oscargao98/4180_Final_Project/1_garden/Speaker.h

#include "mbed.h"
// a new class to play a note on Speaker based on PwmOut class
class Speaker
{
public:
    Speaker(PinName pin) : _pin(pin) {
// _pin(pin) means pass pin to the Speaker Constructor
    }
// class method to play a note based on PwmOut class
    void PlayNote(float frequency, float duration, float volume) {
        _pin.period(1.0/frequency);
        _pin = volume/2.0;
        wait(duration);
        _pin = 0.0;
    }

private:
    PwmOut _pin;
};
